ervanalb/flowstick/flowstick_led_strip_pcbs/gerbers/led_orientation.png

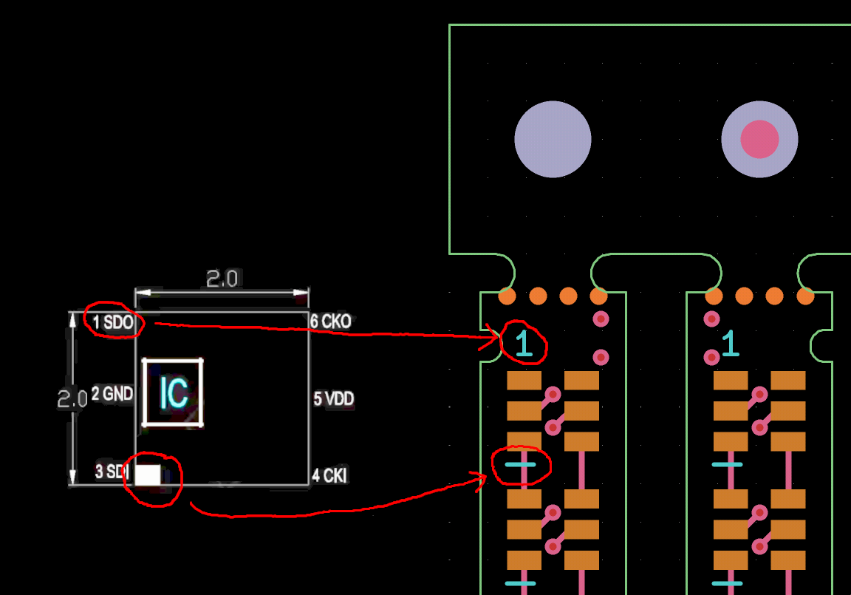
flowstick_led_strip_pcbs/gerbers/led_orientation.png
