ervanalb/flowstick/flowstick_led_strip_pcbs/gerbers/test_fixture_example.png

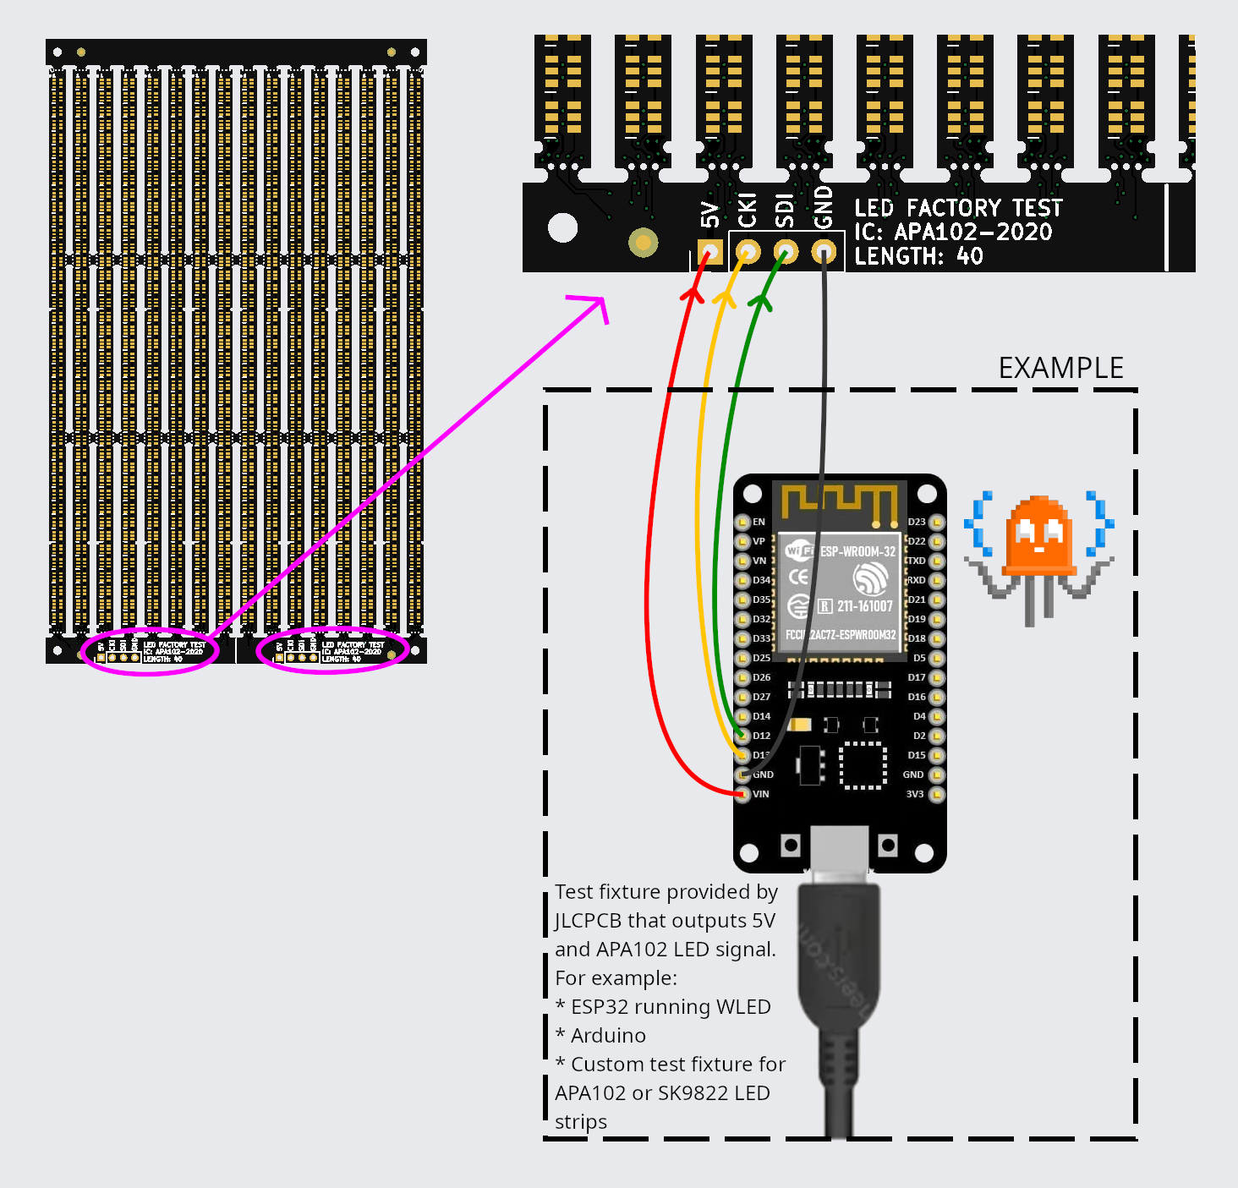
flowstick_led_strip_pcbs/gerbers/test_fixture_example.png
