ervanalb/flowstick/flowstick_led_strip_pcbs/flowstick_led_strip_pcbs.kicad_pcb

## KiCad design flowstick_led_strip_pcbs/flowstick_led_strip_pcbs.kicad_pcb (2025-08-19)

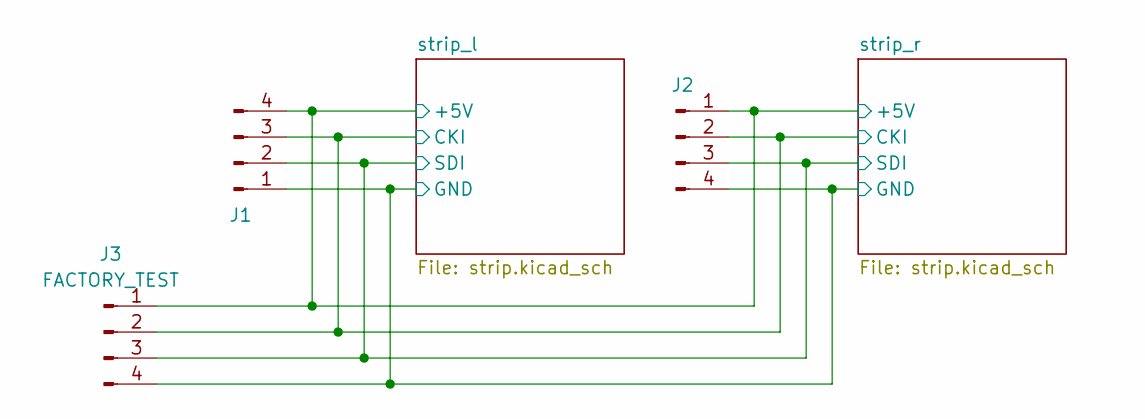
[picture p3: schematic flowstick_led_strip_pcbs.kicad_sch]

Parts:
J1, J2: LED; quad_b2b_pad
J3: FACTORY_TEST; PinHeader_1x04_P2.54mm_Vertical

Connections:
/strip_l/+5V: J1.4, J2.1, J3.1; also elsewhere on the board
/strip_l/CKI: J1.3, J2.2, J3.2; also elsewhere on the board
/strip_l/GND: J1.1, J2.4, J3.4; also elsewhere on the board
/strip_l/SDI: J1.2, J2.3, J3.3; also elsewhere on the board

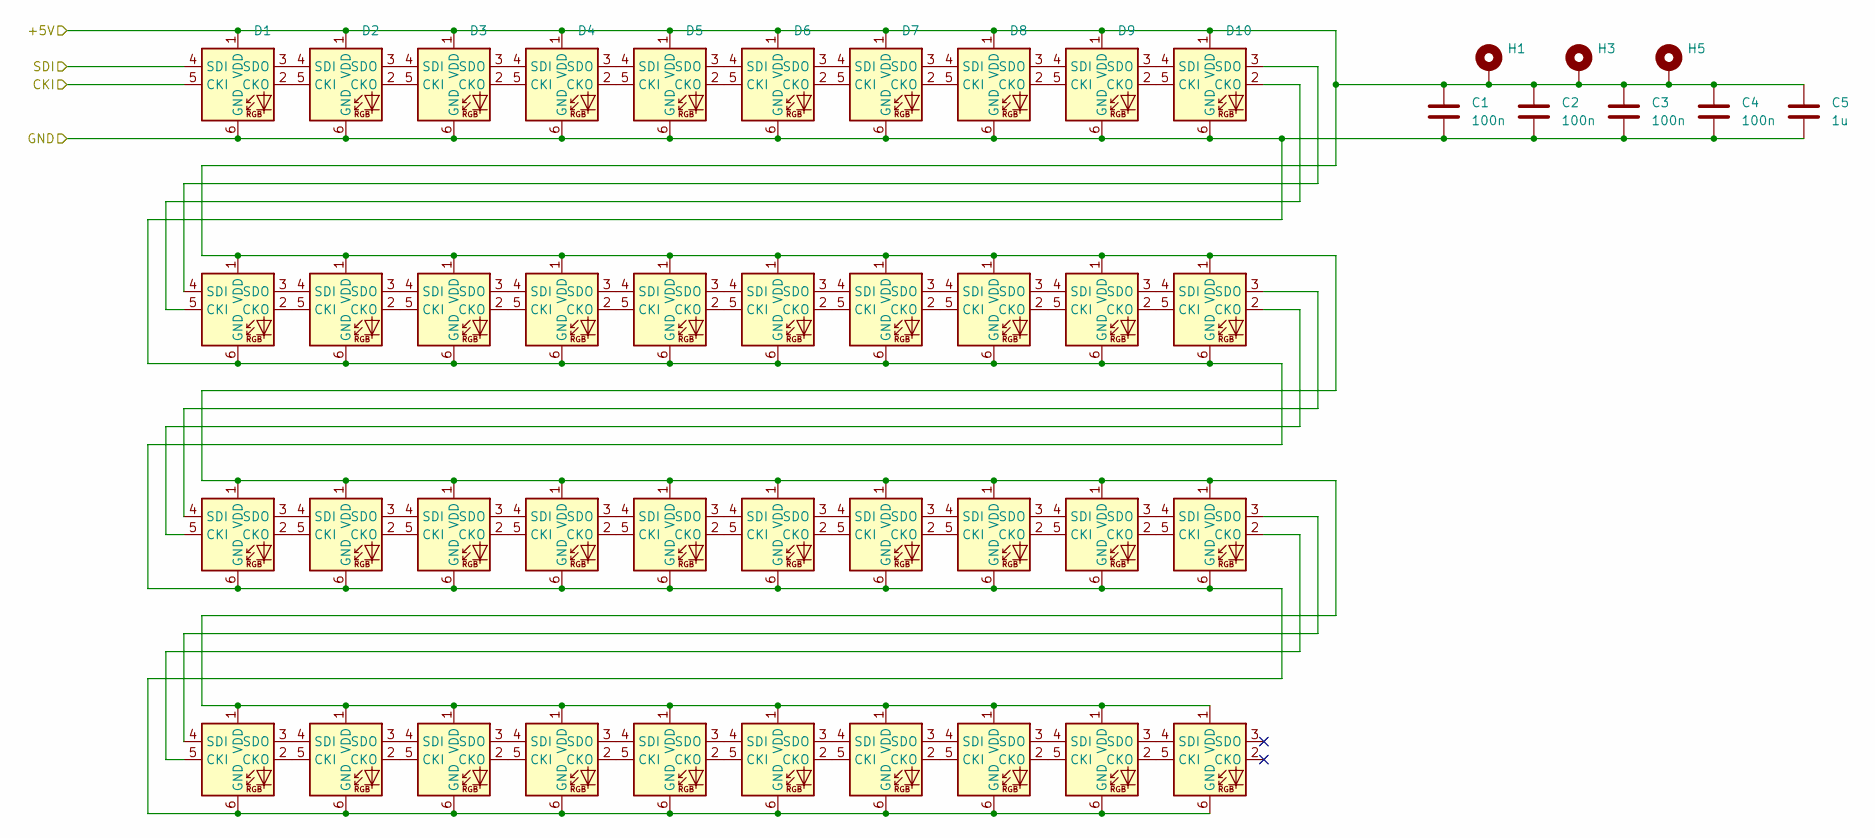
[picture p4: schematic strip.kicad_sch]

Parts:
C1, C2, C3, C4: 100n; C_0603_1608Metric
C5: 1u; C_0603_1608Metric
D1, D2, D3, D4, D5, D6, D7, D8, D9, D10, D11, D12, D13, D14, D15, D16, D17, D18, D19, D20, D21, D22, D23, D24, D25, D26, D27, D28, D29, D30, D31, D32, D33, D34, D35, D36, D37, D38, D39, D40: APA102-2020; LED-APA102-2020-6_90deg
H1, H3, H5: MountingHole_Pad; single_b2b_pad_doublewide

Connections:
/strip_l/+5V: C1.1, C2.1, C3.1, C4.1, C5.1, D1.1 (VDD), D2.1 (VDD), D3.1 (VDD), D4.1 (VDD), D5.1 (VDD), D6.1 (VDD), D7.1 (VDD), D8.1 (VDD), D9.1 (VDD), D10.1 (VDD), D11.1 (VDD), D12.1 (VDD), D13.1 (VDD), D14.1 (VDD), D15.1 (VDD), D16.1 (VDD), D17.1 (VDD), D18.1 (VDD), D19.1 (VDD), D20.1 (VDD), D21.1 (VDD), D22.1 (VDD), D23.1 (VDD), D24.1 (VDD), D25.1 (VDD), D26.1 (VDD), D27.1 (VDD), D28.1 (VDD), D29.1 (VDD), D30.1 (VDD), D31.1 (VDD), D32.1 (VDD), D33.1 (VDD), D34.1 (VDD), D35.1 (VDD), D36.1 (VDD), D37.1 (VDD), D38.1 (VDD), D39.1 (VDD), D40.1 (VDD), H1.1, H3.1, H5.1; also elsewhere on the board
/strip_l/CKI: D1.5 (CKI); also elsewhere on the board
/strip_l/GND: C1.2, C2.2, C3.2, C4.2, C5.2, D1.6 (GND), D2.6 (GND), D3.6 (GND), D4.6 (GND), D5.6 (GND), D6.6 (GND), D7.6 (GND), D8.6 (GND), D9.6 (GND), D10.6 (GND), D11.6 (GND), D12.6 (GND), D13.6 (GND), D14.6 (GND), D15.6 (GND), D16.6 (GND), D17.6 (GND), D18.6 (GND), D19.6 (GND), D20.6 (GND), D21.6 (GND), D22.6 (GND), D23.6 (GND), D24.6 (GND), D25.6 (GND), D26.6 (GND), D27.6 (GND), D28.6 (GND), D29.6 (GND), D30.6 (GND), D31.6 (GND), D32.6 (GND), D33.6 (GND), D34.6 (GND), D35.6 (GND), D36.6 (GND), D37.6 (GND), D38.6 (GND), D39.6 (GND), D40.6 (GND); also elsewhere on the board
/strip_l/SDI: D1.4 (SDI); also elsewhere on the board
unnamed: D1.2 (CKO), D2.5 (CKI)
unnamed: D1.3 (SDO), D2.4 (SDI)
unnamed: D2.2 (CKO), D3.5 (CKI)
unnamed: D2.3 (SDO), D3.4 (SDI)
unnamed: D3.2 (CKO), D4.5 (CKI)
unnamed: D3.3 (SDO), D4.4 (SDI)
unnamed: D4.2 (CKO), D5.5 (CKI)
unnamed: D4.3 (SDO), D5.4 (SDI)
unnamed: D5.2 (CKO), D6.5 (CKI)
unnamed: D5.3 (SDO), D6.4 (SDI)
unnamed: D6.2 (CKO), D7.5 (CKI)
unnamed: D6.3 (SDO), D7.4 (SDI)
unnamed: D7.2 (CKO), D8.5 (CKI)
unnamed: D7.3 (SDO), D8.4 (SDI)
unnamed: D8.2 (CKO), D9.5 (CKI)
unnamed: D8.3 (SDO), D9.4 (SDI)
unnamed: D9.2 (CKO), D10.5 (CKI)
unnamed: D10.2 (CKO), D11.5 (CKI)
unnamed: D9.3 (SDO), D10.4 (SDI)
unnamed: D10.3 (SDO), D11.4 (SDI)
unnamed: D11.2 (CKO), D12.5 (CKI)
unnamed: D11.3 (SDO), D12.4 (SDI)
unnamed: D12.2 (CKO), D13.5 (CKI)
unnamed: D12.3 (SDO), D13.4 (SDI)
unnamed: D13.2 (CKO), D14.5 (CKI)
unnamed: D13.3 (SDO), D14.4 (SDI)
unnamed: D14.2 (CKO), D15.5 (CKI)
unnamed: D14.3 (SDO), D15.4 (SDI)
unnamed: D15.2 (CKO), D16.5 (CKI)
unnamed: D15.3 (SDO), D16.4 (SDI)
unnamed: D16.2 (CKO), D17.5 (CKI)
unnamed: D16.3 (SDO), D17.4 (SDI)
unnamed: D17.2 (CKO), D18.5 (CKI)
unnamed: D17.3 (SDO), D18.4 (SDI)
unnamed: D18.2 (CKO), D19.5 (CKI)
unnamed: D18.3 (SDO), D19.4 (SDI)
unnamed: D19.2 (CKO), D20.5 (CKI)
unnamed: D19.3 (SDO), D20.4 (SDI)
unnamed: D20.2 (CKO), D21.5 (CKI)
unnamed: D20.3 (SDO), D21.4 (SDI)
unnamed: D21.2 (CKO), D22.5 (CKI)
unnamed: D21.3 (SDO), D22.4 (SDI)
unnamed: D22.2 (CKO), D23.5 (CKI)
unnamed: D22.3 (SDO), D23.4 (SDI)
unnamed: D23.2 (CKO), D24.5 (CKI)
unnamed: D23.3 (SDO), D24.4 (SDI)
unnamed: D24.2 (CKO), D25.5 (CKI)
unnamed: D24.3 (SDO), D25.4 (SDI)
unnamed: D25.2 (CKO), D26.5 (CKI)
unnamed: D25.3 (SDO), D26.4 (SDI)
unnamed: D26.2 (CKO), D27.5 (CKI)
unnamed: D26.3 (SDO), D27.4 (SDI)
unnamed: D27.2 (CKO), D28.5 (CKI)
unnamed: D27.3 (SDO), D28.4 (SDI)
unnamed: D28.2 (CKO), D29.5 (CKI)
unnamed: D28.3 (SDO), D29.4 (SDI)
unnamed: D29.2 (CKO), D30.5 (CKI)
unnamed: D29.3 (SDO), D30.4 (SDI)
unnamed: D30.2 (CKO), D31.5 (CKI)
unnamed: D30.3 (SDO), D31.4 (SDI)
unnamed: D31.2 (CKO), D32.5 (CKI)
unnamed: D31.3 (SDO), D32.4 (SDI)
unnamed: D32.2 (CKO), D33.5 (CKI)
unnamed: D32.3 (SDO), D33.4 (SDI)
unnamed: D33.2 (CKO), D34.5 (CKI)
unnamed: D33.3 (SDO), D34.4 (SDI)
unnamed: D34.2 (CKO), D35.5 (CKI)
unnamed: D34.3 (SDO), D35.4 (SDI)
unnamed: D35.2 (CKO), D36.5 (CKI)
unnamed: D35.3 (SDO), D36.4 (SDI)
unnamed: D36.2 (CKO), D37.5 (CKI)
unnamed: D36.3 (SDO), D37.4 (SDI)
unnamed: D37.2 (CKO), D38.5 (CKI)
unnamed: D37.3 (SDO), D38.4 (SDI)
unnamed: D38.2 (CKO), D39.5 (CKI)
unnamed: D38.3 (SDO), D39.4 (SDI)
unnamed: D39.2 (CKO), D40.5 (CKI)
unnamed: D39.3 (SDO), D40.4 (SDI)

Parts of its further copies:
C6, C7, C8, C9: 100n; C_0603_1608Metric
C10: 1u; C_0603_1608Metric
D41, D42, D43, D44, D45, D46, D47, D48, D49, D50, D51, D52, D53, D54, D55, D56, D57, D58, D59, D60, D61, D62, D63, D64, D65, D66, D67, D68, D69, D70, D71, D72, D73, D74, D75, D76, D77, D78, D79, D80: APA102-2020; LED-APA102-2020-6_90deg
H2, H4, H6: MountingHole_Pad; single_b2b_pad_doublewide

Connections of its further copies:
/strip_l/+5V: C6.1, C7.1, C8.1, C9.1, C10.1, D41.1 (VDD), D42.1 (VDD), D43.1 (VDD), D44.1 (VDD), D45.1 (VDD), D46.1 (VDD), D47.1 (VDD), D48.1 (VDD), D49.1 (VDD), D50.1 (VDD), D51.1 (VDD), D52.1 (VDD), D53.1 (VDD), D54.1 (VDD), D55.1 (VDD), D56.1 (VDD), D57.1 (VDD), D58.1 (VDD), D59.1 (VDD), D60.1 (VDD), D61.1 (VDD), D62.1 (VDD), D63.1 (VDD), D64.1 (VDD), D65.1 (VDD), D66.1 (VDD), D67.1 (VDD), D68.1 (VDD), D69.1 (VDD), D70.1 (VDD), D71.1 (VDD), D72.1 (VDD), D73.1 (VDD), D74.1 (VDD), D75.1 (VDD), D76.1 (VDD), D77.1 (VDD), D78.1 (VDD), D79.1 (VDD), D80.1 (VDD), H2.1, H4.1, H6.1; also elsewhere on the board
/strip_l/CKI: D41.5 (CKI); also elsewhere on the board
/strip_l/GND: C6.2, C7.2, C8.2, C9.2, C10.2, D41.6 (GND), D42.6 (GND), D43.6 (GND), D44.6 (GND), D45.6 (GND), D46.6 (GND), D47.6 (GND), D48.6 (GND), D49.6 (GND), D50.6 (GND), D51.6 (GND), D52.6 (GND), D53.6 (GND), D54.6 (GND), D55.6 (GND), D56.6 (GND), D57.6 (GND), D58.6 (GND), D59.6 (GND), D60.6 (GND), D61.6 (GND), D62.6 (GND), D63.6 (GND), D64.6 (GND), D65.6 (GND), D66.6 (GND), D67.6 (GND), D68.6 (GND), D69.6 (GND), D70.6 (GND), D71.6 (GND), D72.6 (GND), D73.6 (GND), D74.6 (GND), D75.6 (GND), D76.6 (GND), D77.6 (GND), D78.6 (GND), D79.6 (GND), D80.6 (GND); also elsewhere on the board
/strip_l/SDI: D41.4 (SDI); also elsewhere on the board
unnamed: D41.2 (CKO), D42.5 (CKI)
unnamed: D41.3 (SDO), D42.4 (SDI)
unnamed: D42.2 (CKO), D43.5 (CKI)
unnamed: D42.3 (SDO), D43.4 (SDI)
unnamed: D43.2 (CKO), D44.5 (CKI)
unnamed: D43.3 (SDO), D44.4 (SDI)
unnamed: D44.2 (CKO), D45.5 (CKI)
unnamed: D44.3 (SDO), D45.4 (SDI)
unnamed: D45.2 (CKO), D46.5 (CKI)
unnamed: D45.3 (SDO), D46.4 (SDI)
unnamed: D46.2 (CKO), D47.5 (CKI)
unnamed: D46.3 (SDO), D47.4 (SDI)
unnamed: D47.2 (CKO), D48.5 (CKI)
unnamed: D47.3 (SDO), D48.4 (SDI)
unnamed: D48.2 (CKO), D49.5 (CKI)
unnamed: D48.3 (SDO), D49.4 (SDI)
unnamed: D49.2 (CKO), D50.5 (CKI)
unnamed: D49.3 (SDO), D50.4 (SDI)
unnamed: D50.2 (CKO), D51.5 (CKI)
unnamed: D50.3 (SDO), D51.4 (SDI)
unnamed: D51.2 (CKO), D52.5 (CKI)
unnamed: D51.3 (SDO), D52.4 (SDI)
unnamed: D52.2 (CKO), D53.5 (CKI)
unnamed: D52.3 (SDO), D53.4 (SDI)
unnamed: D53.2 (CKO), D54.5 (CKI)
unnamed: D53.3 (SDO), D54.4 (SDI)
unnamed: D54.2 (CKO), D55.5 (CKI)
unnamed: D54.3 (SDO), D55.4 (SDI)
unnamed: D55.2 (CKO), D56.5 (CKI)
unnamed: D55.3 (SDO), D56.4 (SDI)
unnamed: D56.2 (CKO), D57.5 (CKI)
unnamed: D56.3 (SDO), D57.4 (SDI)
unnamed: D57.2 (CKO), D58.5 (CKI)
unnamed: D57.3 (SDO), D58.4 (SDI)
unnamed: D58.2 (CKO), D59.5 (CKI)
unnamed: D58.3 (SDO), D59.4 (SDI)
unnamed: D59.2 (CKO), D60.5 (CKI)
unnamed: D59.3 (SDO), D60.4 (SDI)
unnamed: D60.2 (CKO), D61.5 (CKI)
unnamed: D60.3 (SDO), D61.4 (SDI)
unnamed: D61.2 (CKO), D62.5 (CKI)
unnamed: D61.3 (SDO), D62.4 (SDI)
unnamed: D62.2 (CKO), D63.5 (CKI)
unnamed: D62.3 (SDO), D63.4 (SDI)
unnamed: D63.2 (CKO), D64.5 (CKI)
unnamed: D63.3 (SDO), D64.4 (SDI)
unnamed: D64.2 (CKO), D65.5 (CKI)
unnamed: D64.3 (SDO), D65.4 (SDI)
unnamed: D65.2 (CKO), D66.5 (CKI)
unnamed: D65.3 (SDO), D66.4 (SDI)
unnamed: D66.2 (CKO), D67.5 (CKI)
unnamed: D66.3 (SDO), D67.4 (SDI)
unnamed: D67.2 (CKO), D68.5 (CKI)
unnamed: D67.3 (SDO), D68.4 (SDI)
unnamed: D68.2 (CKO), D69.5 (CKI)
unnamed: D68.3 (SDO), D69.4 (SDI)
unnamed: D69.2 (CKO), D70.5 (CKI)
unnamed: D69.3 (SDO), D70.4 (SDI)
unnamed: D70.2 (CKO), D71.5 (CKI)
unnamed: D70.3 (SDO), D71.4 (SDI)
unnamed: D71.2 (CKO), D72.5 (CKI)
unnamed: D71.3 (SDO), D72.4 (SDI)
unnamed: D72.2 (CKO), D73.5 (CKI)
unnamed: D72.3 (SDO), D73.4 (SDI)
unnamed: D73.2 (CKO), D74.5 (CKI)
unnamed: D73.3 (SDO), D74.4 (SDI)
unnamed: D74.2 (CKO), D75.5 (CKI)
unnamed: D74.3 (SDO), D75.4 (SDI)
unnamed: D75.2 (CKO), D76.5 (CKI)
unnamed: D75.3 (SDO), D76.4 (SDI)
unnamed: D76.2 (CKO), D77.5 (CKI)
unnamed: D76.3 (SDO), D77.4 (SDI)
unnamed: D77.2 (CKO), D78.5 (CKI)
unnamed: D77.3 (SDO), D78.4 (SDI)
unnamed: D78.2 (CKO), D79.5 (CKI)
unnamed: D78.3 (SDO), D79.4 (SDI)
unnamed: D79.2 (CKO), D80.5 (CKI)
unnamed: D79.3 (SDO), D80.4 (SDI)

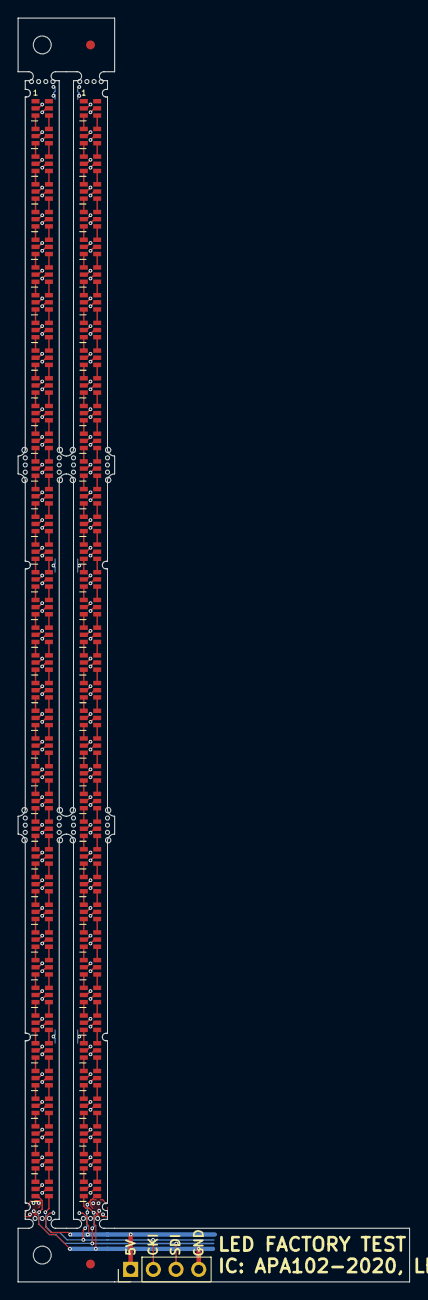
[picture p5: board flowstick_led_strip_pcbs.kicad_pcb from above]

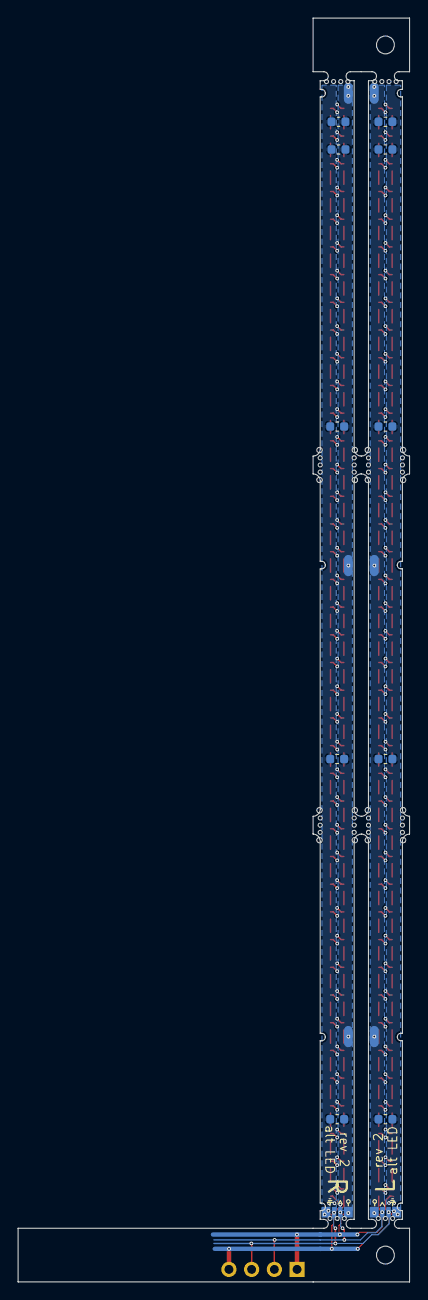
[picture p6: board flowstick_led_strip_pcbs.kicad_pcb from below]

Board: 2 copper layers, 43.8 x 141.4 mm, 99 parts (18 on the bottom side), 160 nets.
