ervanalb/flowstick/flowstick_main_pcb/flowstick_main_pcb.kicad_pcb

## KiCad design flowstick_main_pcb/flowstick_main_pcb.kicad_pcb (2025-08-11)

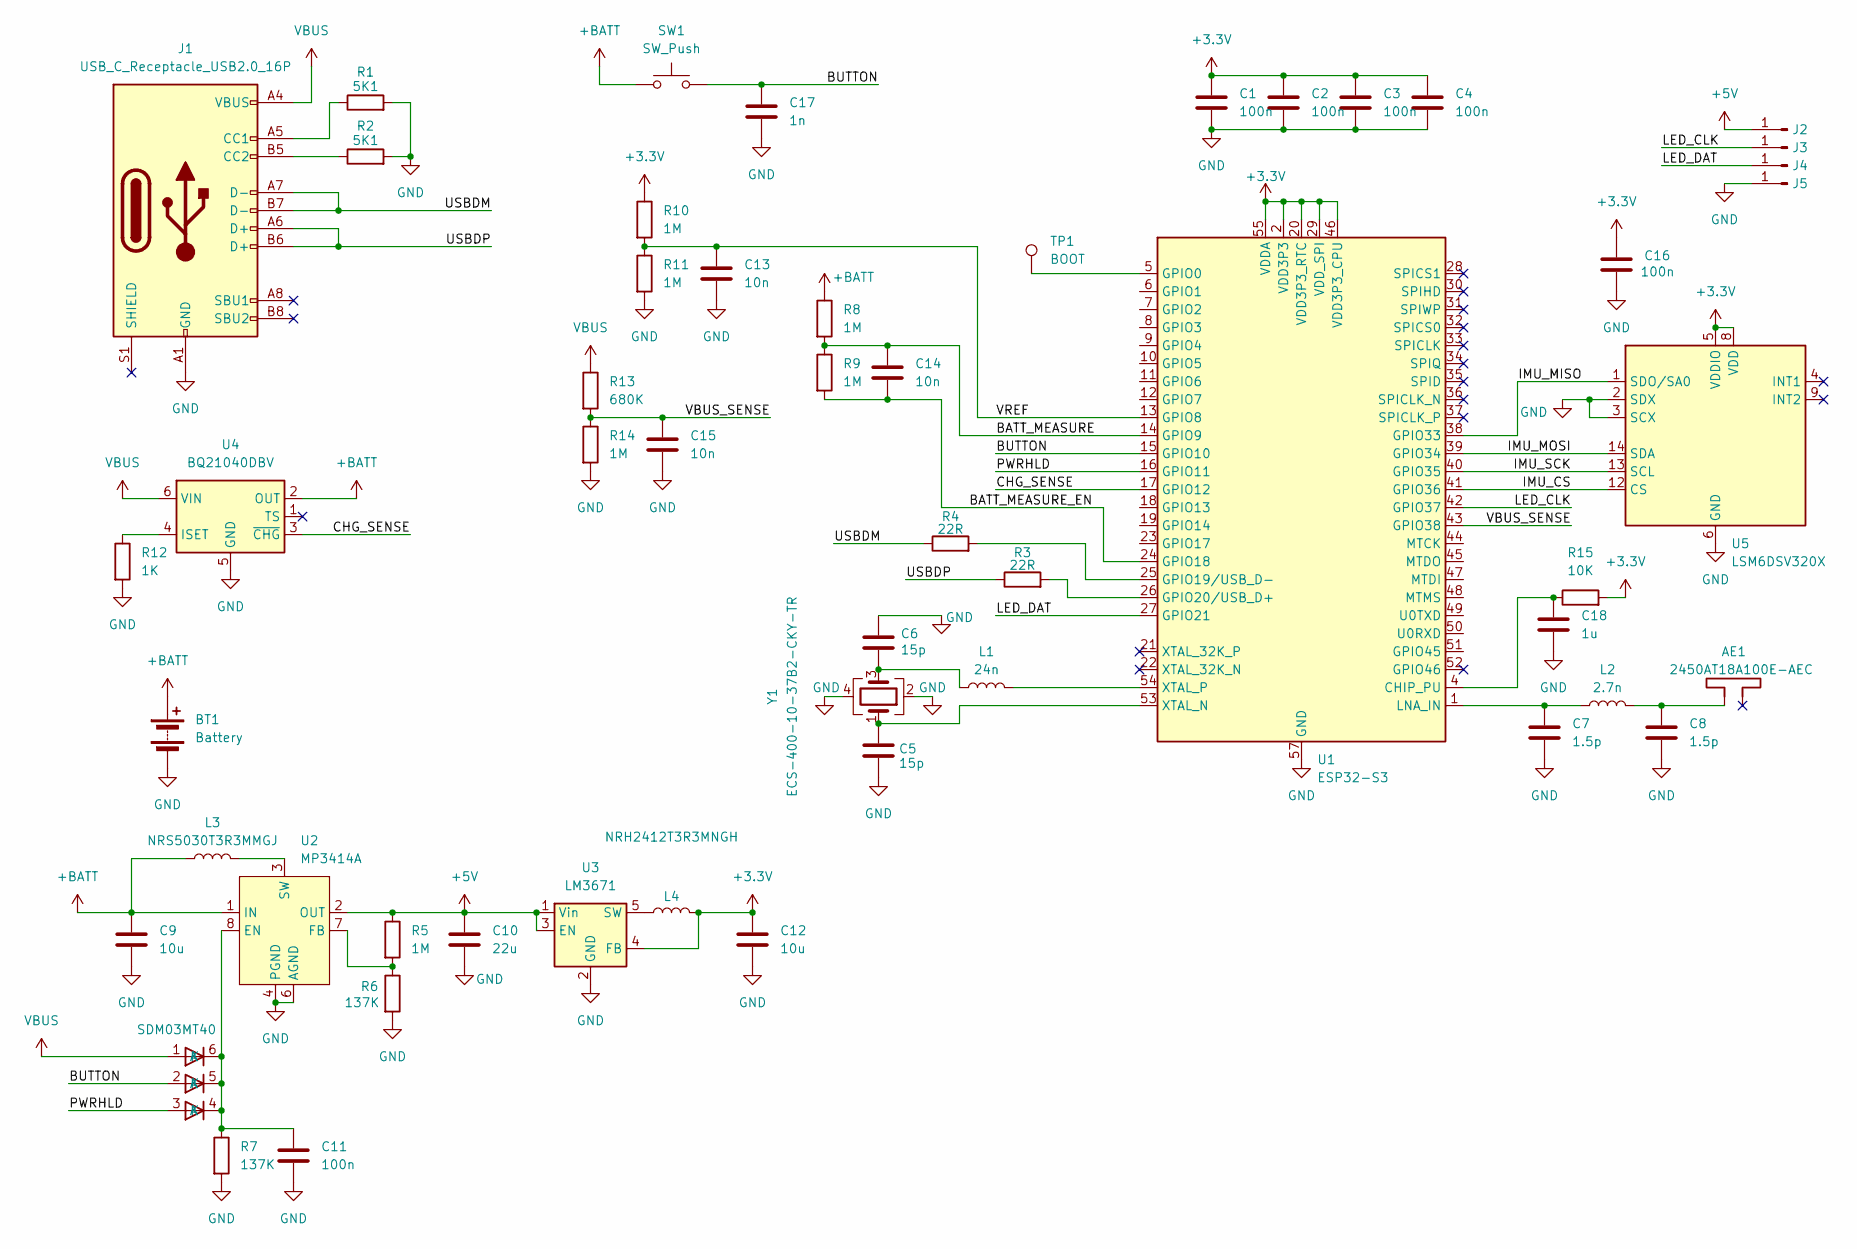
[picture p7: schematic flowstick_main_pcb.kicad_sch]

Parts:
AE1: 2450AT18A100E-AEC; R_1206_3216Metric
BT1: Battery; PinHeader_1x02_P2.54mm_Vertical
C1, C2, C3, C4, C16: 100n; C_0402_1005Metric
C5, C6: 15p; C_0201_0603Metric
C7, C8: 1.5p; C_0201_0603Metric
C9, C12: 10u; C_1206_3216Metric
C10: 22u; C_1206_3216Metric
C11: 100n; C_0201_0603Metric
C13, C14, C15: 10n; C_0201_0603Metric
C17: 1n; C_0201_0603Metric
C18: 1u; C_0201_0603Metric
D1: SDM03MT40; SOT-23-6
J1: USB_C_Receptacle_USB2.0_16P; USB_C_Receptacle_GCT_USB4105-xx-A_16P_TopMnt_Horizontal
J2, J3, J4, J5: Conn_01x01_Pin; Untitled
L1: 24n; L_0201_0603Metric
L2: 2.7n; L_0201_0603Metric
L3: NRS5030T3R3MMGJ; L_Taiyo-Yuden_NR-50xx
L4: NRH2412T3R3MNGH; L_Taiyo-Yuden_NR-24xx
R1, R2: 5K1; C_0201_0603Metric
R3, R4: 22R; C_0201_0603Metric
R5, R8, R9, R10, R11, R14: 1M; C_0201_0603Metric
R6, R7: 137K; C_0201_0603Metric
R12: 1K; C_0201_0603Metric
R13: 680K; C_0201_0603Metric
R15: 10K; R_0201_0603Metric
SW1: SW_Push; SW_SPST_EVQP7C
TP1: BOOT; TestPoint_Pad_D1.0mm
U1: ESP32-S3; QFN-56-1EP_7x7mm_P0.4mm_EP4x4mm
U2: MP3414A; TSOT-23-8
U3: LM3671; TSOT-23-5
U4: BQ21040DBV; SOT-23-6
U5: LSM6DSV320X; LGA-14_3x2.5mm_P0.5mm_LayoutBorder3x4y
Y1: ECS-400-10-37B2-CKY-TR; Crystal_SMD_2016-4Pin_2.0x1.6mm

Connections:
+3.3V: C1.1, C2.1, C3.1, C4.1, C12.1, C16.1, L4.2, R10.1, R15.2, U1.2 (VDD3P3), U1.3 (VDD3P3), U1.20 (VDD3P3_RTC), U1.29 (VDD_SPI), U1.46 (VDD3P3_CPU), U1.55 (VDDA), U1.56 (VDDA), U3.4 (FB), U5.5 (VDDIO), U5.8 (VDD)
+5V: C10.1, J2.1, R5.1, U2.2 (OUT), U3.1 (Vin), U3.3 (EN)
+BATT: BT1.1 (+), C9.1, L3.1, R8.1, SW1.1, U2.1 (IN), U4.2 (OUT)
/BATT_MEASURE: C14.1, R8.2, R9.1, U1.14 (GPIO9)
/BATT_MEASURE_EN: C14.2, R9.2, U1.24 (GPIO18)
/BUTTON: C17.1, D1.2 (A), SW1.2, U1.15 (GPIO10)
/CHG_SENSE: U1.17 (GPIO12), U4.3 (~CHG)
/IMU_CS: U1.41 (GPIO36), U5.12 (CS)
/IMU_PICO: U1.38 (GPIO33), U5.1 (SDO/SA0)
/IMU_POCI: U1.39 (GPIO34), U5.14 (SDA)
/IMU_SCK: U1.40 (GPIO35), U5.13 (SCL)
/LED_CLK: J3.1, U1.42 (GPIO37)
/LED_DAT: J4.1, U1.27 (GPIO21)
/PWRHLD: D1.3 (A), U1.16 (GPIO11)
/USBDM: J1.A7 (D-), J1.B7 (D-), R4.1
/USBDP: J1.A6 (D+), J1.B6 (D+), R3.1
/VBUS_SENSE: C15.1, R13.2, R14.1, U1.43 (GPIO38)
/VREF: C13.1, R10.2, R11.1, U1.13 (GPIO8)
GND: BT1.2 (-), C1.2, C2.2, C3.2, C4.2, C5.2, C6.1, C7.2, C8.2, C9.2, C10.2, C11.2, C12.2, C13.2, C15.2, C16.2, C17.2, C18.2, J1.A1 (GND), J1.A12 (GND), J1.B1 (GND), J1.B12 (GND), J5.1, R1.2, R2.2, R6.2, R7.2, R11.2, R12.2, R14.2, U1.57 (GND), U2.4 (PGND), U2.6 (AGND), U3.2 (GND), U4.5 (GND), U5.2 (SDX), U5.3 (SCX), U5.6 (GND), U5.7 (GND), Y1.2, Y1.4
unnamed: AE1.1, C8.1, L2.2
unnamed: C6.2, L1.1, Y1.3
unnamed: C11.1, D1.4 (K), D1.5 (K), D1.6 (K), R7.1, U2.8 (EN)
unnamed: J1.A5 (CC1), R1.1
unnamed: J1.B5 (CC2), R2.1
unnamed: C18.1, R15.1, U1.4 (CHIP_PU)
unnamed: TP1.1, U1.5 (GPIO0)
unnamed: R4.2, U1.25 (GPIO19/USB_D-)
unnamed: R3.2, U1.26 (GPIO20/USB_D+)
unnamed: C7.1, L2.1, U1.1 (LNA_IN)
unnamed: C5.1, U1.53 (XTAL_N), Y1.1
unnamed: L1.2, U1.54 (XTAL_P)
unnamed: R5.2, R6.1, U2.7 (FB)
unnamed: L3.2, U2.3 (SW)
unnamed: L4.1, U3.5 (SW)
unnamed: R12.1, U4.4 (ISET)
VBUS: D1.1 (A), J1.A4 (VBUS), J1.A9 (VBUS), J1.B4 (VBUS), J1.B9 (VBUS), R13.1, U4.6 (VIN)

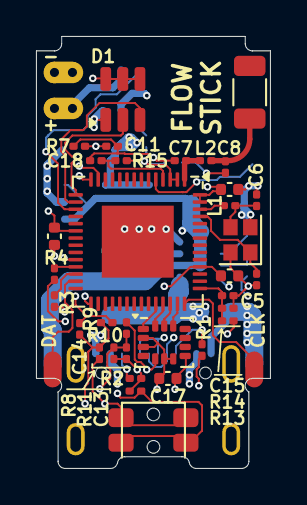
[picture p8: board flowstick_main_pcb.kicad_pcb from above]

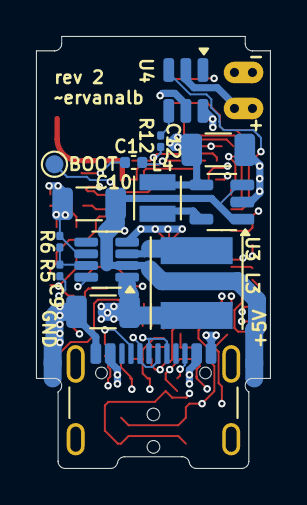
[picture p9: board flowstick_main_pcb.kicad_pcb from below]

Board: 4 copper layers, 13.0 x 24.0 mm, 53 parts (16 on the bottom side), 36 nets.
