ervanalb/flowstick/flowstick_junction_pcb/flowstick_junction_pcb.kicad_pcb

## KiCad design flowstick_junction_pcb/flowstick_junction_pcb.kicad_pcb (2025-08-07)

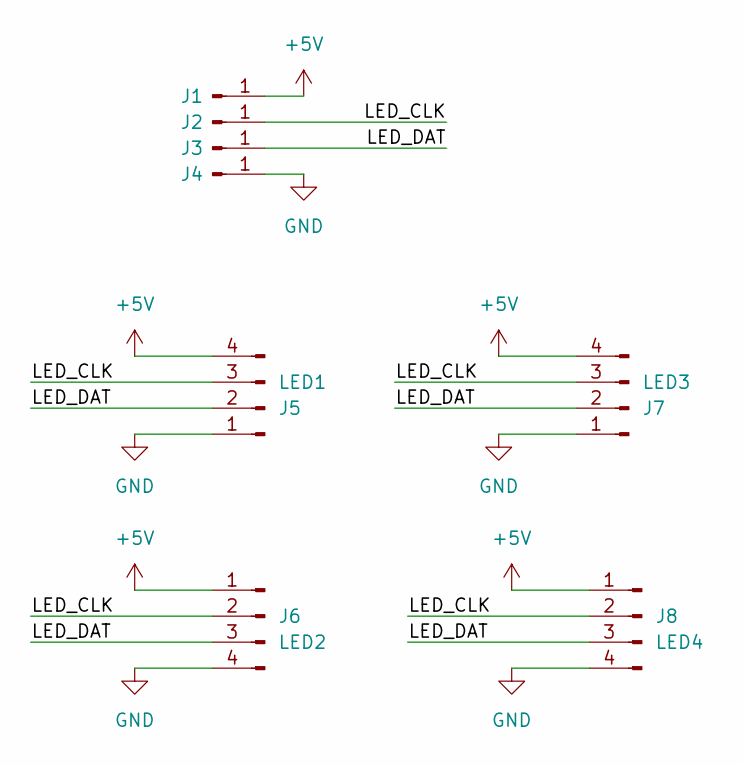
[picture p10: schematic flowstick_junction_pcb.kicad_sch]

Parts:
J1, J2, J3, J4: Conn_01x01_Pin; single_b2b_pad
J5: LED1; quad_b2b_pad
J6: LED2; quad_b2b_pad
J7: LED3; quad_b2b_pad
J8: LED4; quad_b2b_pad

Connections:
+5V: J1.1, J5.4, J6.1, J7.4, J8.1
/LED_CLK: J2.1, J5.3, J6.2, J7.3, J8.2
/LED_DAT: J3.1, J5.2, J6.3, J7.2, J8.3
GND: J4.1, J5.1, J6.4, J7.1, J8.4

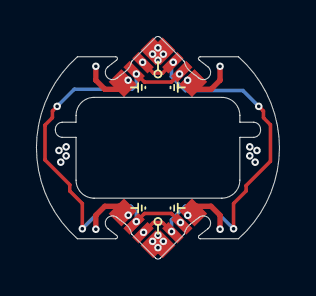
[picture p11: board flowstick_junction_pcb.kicad_pcb from above]

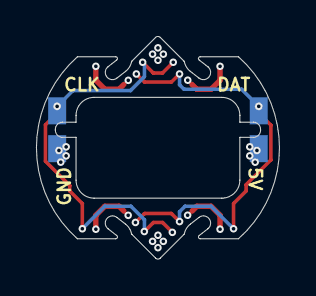
[picture p12: board flowstick_junction_pcb.kicad_pcb from below]

Board: 4 copper layers, 13.5 x 12.4 mm, 8 parts (4 on the bottom side), 4 nets.
