ervanalb/flowstick/(commit log)

2025-07-17 Add rev1 PCB designs
    [flowstick_junction_pcb-B_Cu.gbr, flowstick_junction_pcb-B_Mask.gbr, flowstick_junction_pcb-B_Silkscreen.gbr, flowstick_junction_pcb-Edge_Cuts.gbr, flowstick_junction_pcb-F_Cu.gbr, flowstick_junction_pcb-F_Mask.gbr, flowstick_junction_pcb-F_Silkscreen.gbr, flowstick_junction_pcb-In1_Cu.gbr]
2025-07-18 Fix logging, add simple color fade test
    [main.rs]
2025-07-30 Use I2S + DMA to send LED animations
2025-07-30 add SPI
2025-08-01 ADC for battery & SPI for IMU
2025-08-06 work on rev2 + panelize LED strips
    [flowstick_junction_pcb.kicad_pcb, flowstick_led_strip_pcbs.kicad_pcb, flowstick_led_strip_pcbs.kicad_sch, flowstick_main_pcb.kicad_pcb, flowstick_main_pcb.kicad_sch, flowstick_spacer_pcbs.kicad_pcb, strip.kicad_sch]
2025-08-07 Final rev2, probably
    [bom.csv, flowstick_junction_pcb.kicad_pcb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]
2025-08-11 Hardware rev2 including 6-pin version of LED strip boards. Firmware: begin to integrate embassy, switch LED drivers between low- and high-power
    [bom.csv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]
2025-08-13 Switch to trouble, test out BLE scan
2025-08-19 Update LED strips to use to 6-pin LED package
    [flowstick_led_strip_panel-B_Cu.gbr, flowstick_led_strip_panel-B_Mask.gbr, flowstick_led_strip_panel-B_Paste.gbr, flowstick_led_strip_panel-B_Silkscreen.gbr, flowstick_led_strip_panel-Edge_Cuts.gbr, flowstick_led_strip_panel-F_Cu.gbr, flowstick_led_strip_panel-F_Mask.gbr, flowstick_led_strip_panel-F_Paste.gbr]
2025-08-19 Add LED package with alternate pinout
2025-08-19 Switch to 90 degree alternate LED pinout
    [flowstick_led_strip_panel-B_Cu.gbr, flowstick_led_strip_panel-B_Mask.gbr, flowstick_led_strip_panel-B_Paste.gbr, flowstick_led_strip_panel-B_Silkscreen.gbr, flowstick_led_strip_panel-Edge_Cuts.gbr, flowstick_led_strip_panel-F_Cu.gbr, flowstick_led_strip_panel-F_Mask.gbr, flowstick_led_strip_panel-F_Paste.gbr]
2025-08-22 Add exemplary drawings for factory
    [bom.csv]
2025-09-23 Add patterns, remove logging (caused crashes when sleeping)
    [main.rs]
2025-09-25 play with deep sleep for charging
2025-09-26 Fix up deep sleep for charging mode, add more patterns
    [main.rs]
2025-10-03 Improved battery charging logic -- 3 second deep sleep + 300ms keep awake + fixed animation timing + fixed ADC reading
    [main.rs]
2025-10-08 Accurate battery meter on power-off
2025-10-09 New charging animation & behavior (no sleep)
2025-10-10 Read from IMU
